paulsonnentag/button-grid/hardware/button-grid.kicad_pcb

## KiCad design hardware/button-grid.kicad_pcb (2026-10-14)

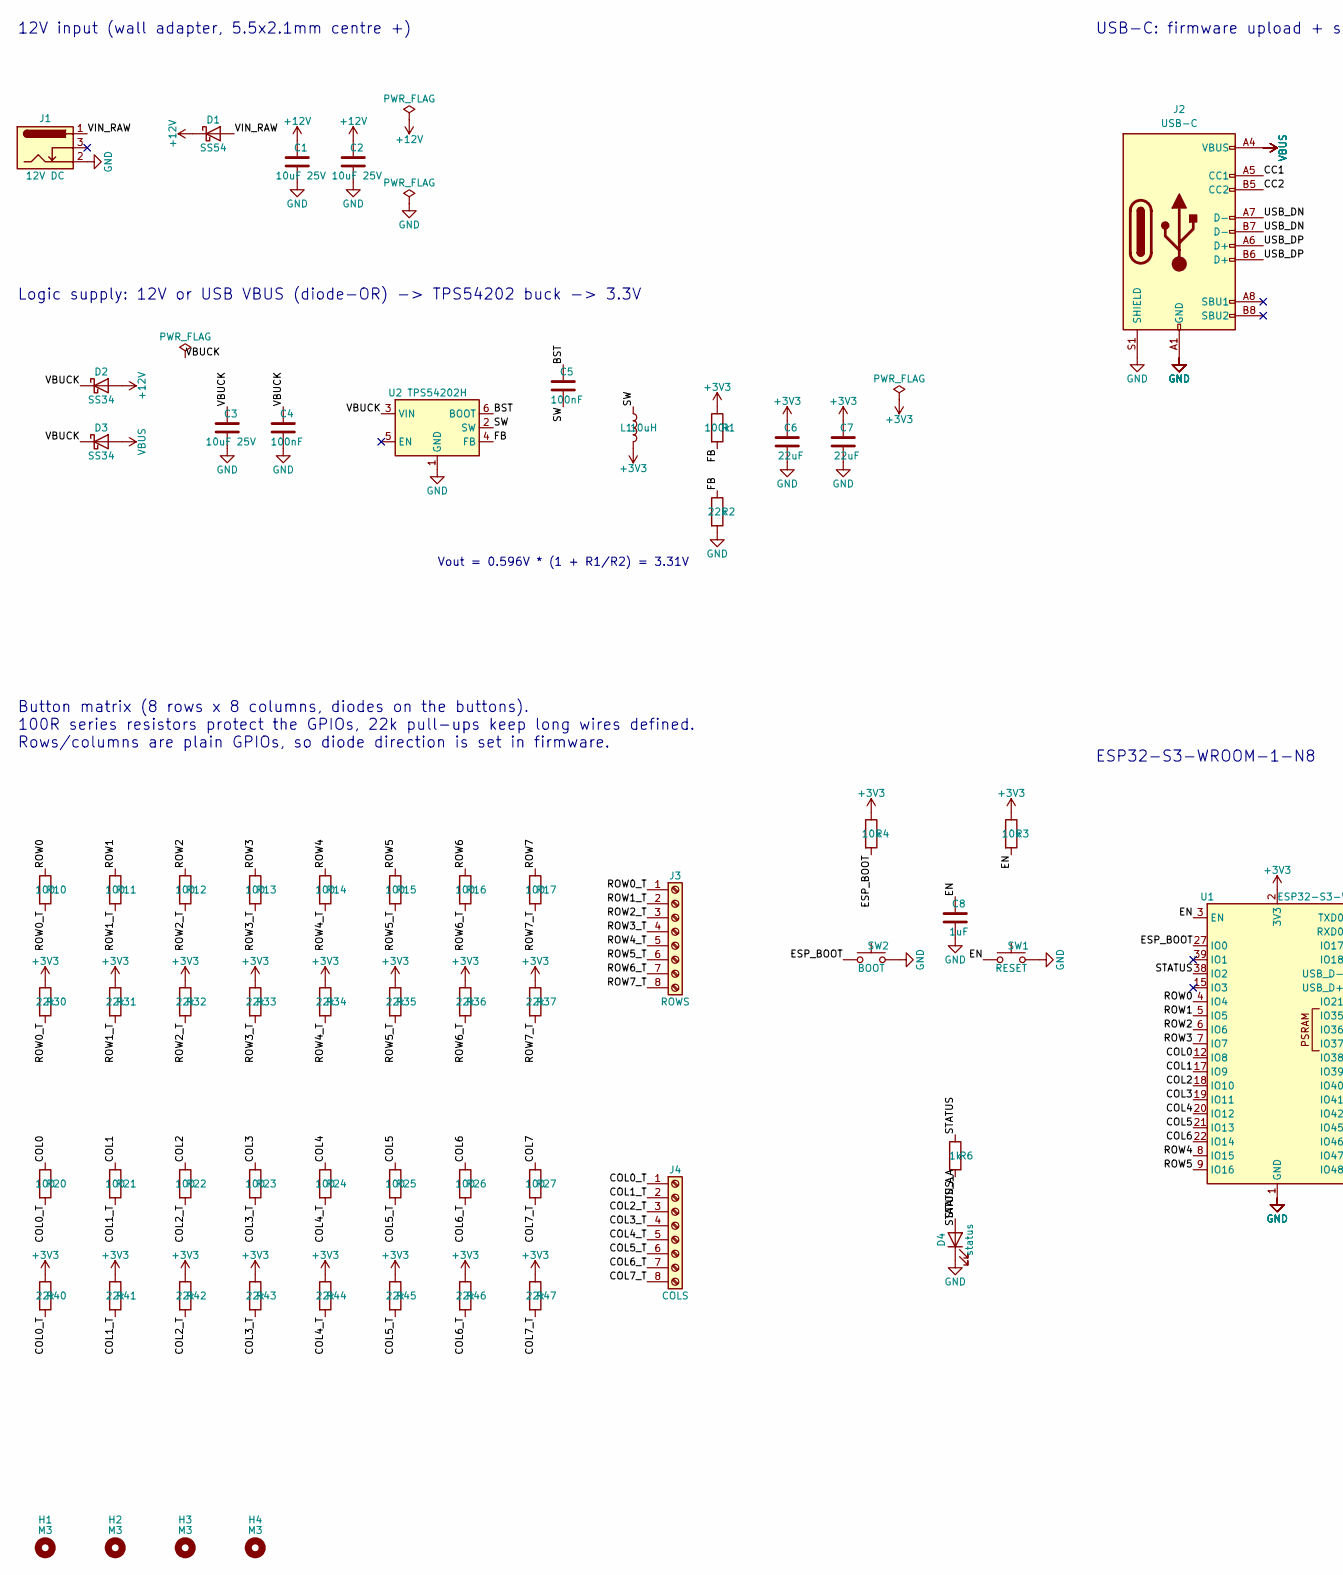
[picture p1: schematic button-grid.kicad_sch, 8x8 button grid controller, part in row 1, column 1]

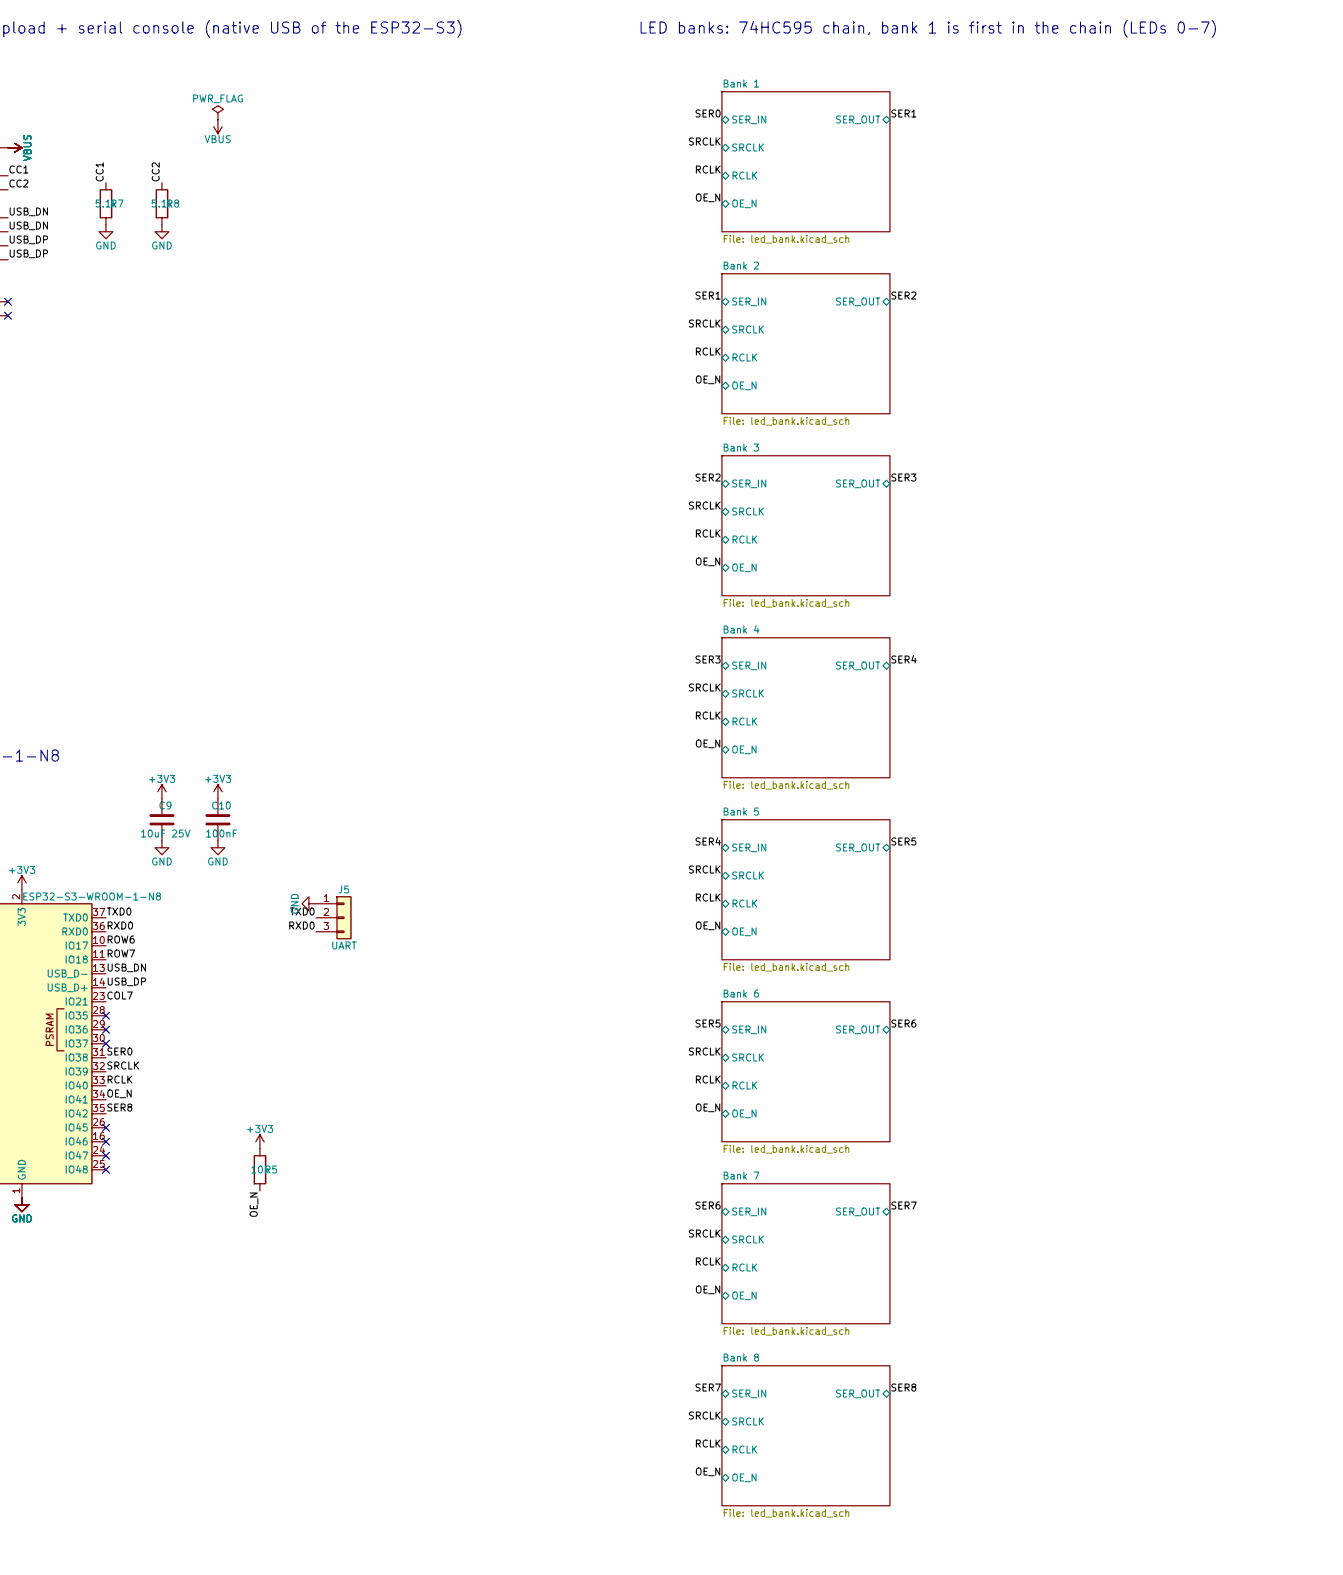
[picture p2: schematic button-grid.kicad_sch, 8x8 button grid controller, part in row 1, column 2]

Parts:
C1, C2, C3, C9: 10uF 25V; C_0805_2012Metric; LCSC C15850
C4, C5, C10: 100nF; C_0603_1608Metric; LCSC C14663
C6, C7: 22uF; C_0805_2012Metric; LCSC C45783
C8: 1uF; C_0603_1608Metric; LCSC C15849
D1: SS54; D_SMA; LCSC C22452
D2, D3: SS34; D_SMA; LCSC C8678
D4: status; LED_0603_1608Metric; LCSC C2286
H1, H2, H3, H4: M3; MountingHole_3.2mm_M3
J1: 12V DC; BarrelJack_Horizontal; LCSC C381116
J2: USB-C; USB_C_Receptacle_HRO_TYPE-C-31-M-12; LCSC C165948
J3: ROWS; TerminalBlock_Phoenix_PT-1,5-8-3.5-H_1x08_P3.50mm_Horizontal
J4: COLS; TerminalBlock_Phoenix_PT-1,5-8-3.5-H_1x08_P3.50mm_Horizontal
J5: UART; PinHeader_1x03_P2.54mm_Vertical
L1: 10uH; L_Sunlord_SWPA4030S; LCSC C38117
R1: 100k; R_0603_1608Metric; LCSC C25803
R2, R30, R31, R32, R33, R34, R35, R36, R37, R40, R41, R42, R43, R44, R45, R46, R47: 22k; R_0603_1608Metric; LCSC C31850
R3, R4, R5: 10k; R_0603_1608Metric; LCSC C25804
R6: 1k; R_0603_1608Metric; LCSC C21190
R7, R8: 5.1k; R_0603_1608Metric; LCSC C23186
R10, R11, R12, R13, R14, R15, R16, R17, R20, R21, R22, R23, R24, R25, R26, R27: 100; R_0603_1608Metric; LCSC C22775
SW1: RESET; SW_PUSH_6mm
SW2: BOOT; SW_PUSH_6mm
U1: ESP32-S3-WROOM-1-N8; ESP32-S3-WROOM-1; LCSC C2913198
U2: TPS54202H; TSOT-23-6; LCSC C527684

Connections:
/BST: C5.1, U2.6 (BOOT)
/CC1: J2.A5 (CC1), R7.1
/CC2: J2.B5 (CC2), R8.1
/COL0: R20.1, U1.12 (IO8)
/COL0_T: J4.1, R20.2, R40.2
/COL1: R21.1, U1.17 (IO9)
/COL1_T: J4.2, R21.2, R41.2
/COL2: R22.1, U1.18 (IO10)
/COL2_T: J4.3, R22.2, R42.2
/COL3: R23.1, U1.19 (IO11)
/COL3_T: J4.4, R23.2, R43.2
/COL4: R24.1, U1.20 (IO12)
/COL4_T: J4.5, R24.2, R44.2
/COL5: R25.1, U1.21 (IO13)
/COL5_T: J4.6, R25.2, R45.2
/COL6: R26.1, U1.22 (IO14)
/COL6_T: J4.7, R26.2, R46.2
/COL7: R27.1, U1.23 (IO21)
/COL7_T: J4.8, R27.2, R47.2
/EN: C8.1, R3.2, SW1.1, U1.3 (EN)
/ESP_BOOT: R4.2, SW2.1, U1.27 (IO0)
/FB: R1.2, R2.1, U2.4 (FB)
/OE_N: R5.2, U1.34 (IO41); also elsewhere on the board
/RCLK: U1.33 (IO40); also elsewhere on the board
/ROW0: R10.1, U1.4 (IO4)
/ROW0_T: J3.1, R10.2, R30.2
/ROW1: R11.1, U1.5 (IO5)
/ROW1_T: J3.2, R11.2, R31.2
/ROW2: R12.1, U1.6 (IO6)
/ROW2_T: J3.3, R12.2, R32.2
/ROW3: R13.1, U1.7 (IO7)
/ROW3_T: J3.4, R13.2, R33.2
/ROW4: R14.1, U1.8 (IO15)
/ROW4_T: J3.5, R14.2, R34.2
/ROW5: R15.1, U1.9 (IO16)
/ROW5_T: J3.6, R15.2, R35.2
/ROW6: R16.1, U1.10 (IO17)
/ROW6_T: J3.7, R16.2, R36.2
/ROW7: R17.1, U1.11 (IO18)
/ROW7_T: J3.8, R17.2, R37.2
/RXD0: J5.3, U1.36 (RXD0)
/SER0: U1.31 (IO38); also elsewhere on the board
/SER8: U1.35 (IO42); also elsewhere on the board
/SRCLK: U1.32 (IO39); also elsewhere on the board
/STATUS: R6.1, U1.38 (IO2)
/STATUS_A: D4.2 (A), R6.2
/SW: C5.2, L1.1, U2.2 (SW)
/TXD0: J5.2, U1.37 (TXD0)
/USB_DN: J2.A7 (D-), J2.B7 (D-), U1.13 (USB_D-)
/USB_DP: J2.A6 (D+), J2.B6 (D+), U1.14 (USB_D+)
/VIN_RAW: D1.2 (A), J1.1

Notes on the sheet:
12V input (wall adapter, 5.5x2.1mm centre +)
Logic supply: 12V or USB VBUS (diode-OR) -> TPS54202 buck -> 3.3V
Vout = 0.596V * (1 + R1/R2) = 3.31V
USB-C: firmware upload + serial console (native USB of the ESP32-S3)
ESP32-S3-WROOM-1-N8
Button matrix (8 rows x 8 columns, diodes on the buttons). 100R series resistors protect the GPIOs, 22k pull-ups keep long wires defined. Rows/columns are plain GPIOs, so diode direction is set in firmware.
LED banks: 74HC595 chain, bank 1 is first in the chain (LEDs 0-7)

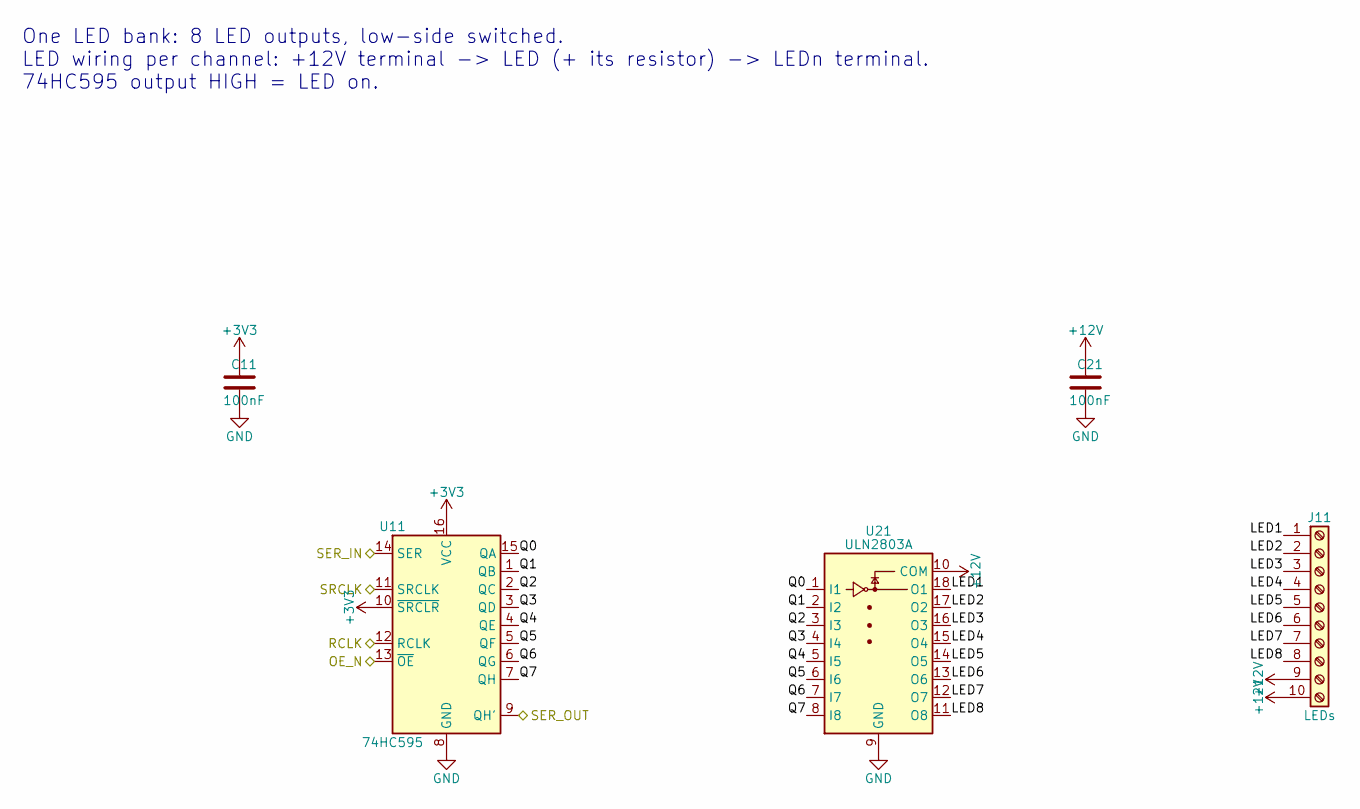
[picture p3: schematic led_bank.kicad_sch, LED bank (8 channels)]

Parts:
C11, C21: 100nF; C_0603_1608Metric; LCSC C14663
J11: LEDs; TerminalBlock_Phoenix_PT-1,5-10-3.5-H_1x10_P3.50mm_Horizont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
U11: 74HC595; SOIC-16_3.9x9.9mm_P1.27mm; LCSC C5947
U21: ULN2803A; SOIC-18W_7.5x11.6mm_P1.27mm; LCSC C9683

Connections:
/Bank 1/LED1: J11.1, U21.18 (O1)
/Bank 1/LED2: J11.2, U21.17 (O2)
/Bank 1/LED3: J11.3, U21.16 (O3)
/Bank 1/LED4: J11.4, U21.15 (O4)
/Bank 1/LED5: J11.5, U21.14 (O5)
/Bank 1/LED6: J11.6, U21.13 (O6)
/Bank 1/LED7: J11.7, U21.12 (O7)
/Bank 1/LED8: J11.8, U21.11 (O8)
/Bank 1/Q0: U11.15 (QA), U21.1 (I1)
/Bank 1/Q1: U11.1 (QB), U21.2 (I2)
/Bank 1/Q2: U11.2 (QC), U21.3 (I3)
/Bank 1/Q3: U11.3 (QD), U21.4 (I4)
/Bank 1/Q4: U11.4 (QE), U21.5 (I5)
/Bank 1/Q5: U11.5 (QF), U21.6 (I6)
/Bank 1/Q6: U11.6 (QG), U21.7 (I7)
/Bank 1/Q7: U11.7 (QH), U21.8 (I8)
/OE_N: U11.13 (~OE); also elsewhere on the board
/RCLK: U11.12 (RCLK); also elsewhere on the board
/SER0: U11.14 (SER); also elsewhere on the board
/SER1: U11.9 (QH'); also elsewhere on the board
/SRCLK: U11.11 (SRCLK); also elsewhere on the board

Parts of its further copies:
C12, C13, C14, C15, C16, C17, C18, C22, C23, C24, C25, C26, C27, C28: 100nF; C_0603_1608Metric; LCSC C14663
J12, J13, J14, J15, J16, J17, J18: LEDs; TerminalBlock_Phoenix_PT-1,5-10-3.5-H_1x10_P3.50mm_Horizont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
U12, U13, U14, U15, U16, U17, U18: 74HC595; SOIC-16_3.9x9.9mm_P1.27mm; LCSC C5947
U22, U23, U24, U25, U26, U27, U28: ULN2803A; SOIC-18W_7.5x11.6mm_P1.27mm; LCSC C9683

Connections of its further copies:
/Bank 2/LED1: J12.1, U22.18 (O1)
/Bank 2/LED2: J12.2, U22.17 (O2)
/Bank 2/LED3: J12.3, U22.16 (O3)
/Bank 2/LED4: J12.4, U22.15 (O4)
/Bank 2/LED5: J12.5, U22.14 (O5)
/Bank 2/LED6: J12.6, U22.13 (O6)
/Bank 2/LED7: J12.7, U22.12 (O7)
/Bank 2/LED8: J12.8, U22.11 (O8)
/Bank 2/Q0: U12.15 (QA), U22.1 (I1)
/Bank 2/Q1: U12.1 (QB), U22.2 (I2)
/Bank 2/Q2: U12.2 (QC), U22.3 (I3)
/Bank 2/Q3: U12.3 (QD), U22.4 (I4)
/Bank 2/Q4: U12.4 (QE), U22.5 (I5)
/Bank 2/Q5: U12.5 (QF), U22.6 (I6)
/Bank 2/Q6: U12.6 (QG), U22.7 (I7)
/Bank 2/Q7: U12.7 (QH), U22.8 (I8)
/Bank 3/LED1: J13.1, U23.18 (O1)
/Bank 3/LED2: J13.2, U23.17 (O2)
/Bank 3/LED3: J13.3, U23.16 (O3)
/Bank 3/LED4: J13.4, U23.15 (O4)
/Bank 3/LED5: J13.5, U23.14 (O5)
/Bank 3/LED6: J13.6, U23.13 (O6)
/Bank 3/LED7: J13.7, U23.12 (O7)
/Bank 3/LED8: J13.8, U23.11 (O8)
/Bank 3/Q0: U13.15 (QA), U23.1 (I1)
/Bank 3/Q1: U13.1 (QB), U23.2 (I2)
/Bank 3/Q2: U13.2 (QC), U23.3 (I3)
/Bank 3/Q3: U13.3 (QD), U23.4 (I4)
/Bank 3/Q4: U13.4 (QE), U23.5 (I5)
/Bank 3/Q5: U13.5 (QF), U23.6 (I6)
/Bank 3/Q6: U13.6 (QG), U23.7 (I7)
/Bank 3/Q7: U13.7 (QH), U23.8 (I8)
/Bank 4/LED1: J14.1, U24.18 (O1)
/Bank 4/LED2: J14.2, U24.17 (O2)
/Bank 4/LED3: J14.3, U24.16 (O3)
/Bank 4/LED4: J14.4, U24.15 (O4)
/Bank 4/LED5: J14.5, U24.14 (O5)
/Bank 4/LED6: J14.6, U24.13 (O6)
/Bank 4/LED7: J14.7, U24.12 (O7)
/Bank 4/LED8: J14.8, U24.11 (O8)
/Bank 4/Q0: U14.15 (QA), U24.1 (I1)
/Bank 4/Q1: U14.1 (QB), U24.2 (I2)
/Bank 4/Q2: U14.2 (QC), U24.3 (I3)
/Bank 4/Q3: U14.3 (QD), U24.4 (I4)
/Bank 4/Q4: U14.4 (QE), U24.5 (I5)
/Bank 4/Q5: U14.5 (QF), U24.6 (I6)
/Bank 4/Q6: U14.6 (QG), U24.7 (I7)
/Bank 4/Q7: U14.7 (QH), U24.8 (I8)
/Bank 5/LED1: J15.1, U25.18 (O1)
/Bank 5/LED2: J15.2, U25.17 (O2)
/Bank 5/LED3: J15.3, U25.16 (O3)
/Bank 5/LED4: J15.4, U25.15 (O4)
/Bank 5/LED5: J15.5, U25.14 (O5)
/Bank 5/LED6: J15.6, U25.13 (O6)
/Bank 5/LED7: J15.7, U25.12 (O7)
/Bank 5/LED8: J15.8, U25.11 (O8)
/Bank 5/Q0: U15.15 (QA), U25.1 (I1)
/Bank 5/Q1: U15.1 (QB), U25.2 (I2)
/Bank 5/Q2: U15.2 (QC), U25.3 (I3)
/Bank 5/Q3: U15.3 (QD), U25.4 (I4)
/Bank 5/Q4: U15.4 (QE), U25.5 (I5)
/Bank 5/Q5: U15.5 (QF), U25.6 (I6)
/Bank 5/Q6: U15.6 (QG), U25.7 (I7)
/Bank 5/Q7: U15.7 (QH), U25.8 (I8)
/Bank 6/LED1: J16.1, U26.18 (O1)
/Bank 6/LED2: J16.2, U26.17 (O2)
/Bank 6/LED3: J16.3, U26.16 (O3)
/Bank 6/LED4: J16.4, U26.15 (O4)
/Bank 6/LED5: J16.5, U26.14 (O5)
/Bank 6/LED6: J16.6, U26.13 (O6)
/Bank 6/LED7: J16.7, U26.12 (O7)
/Bank 6/LED8: J16.8, U26.11 (O8)
/Bank 6/Q0: U16.15 (QA), U26.1 (I1)
/Bank 6/Q1: U16.1 (QB), U26.2 (I2)
/Bank 6/Q2: U16.2 (QC), U26.3 (I3)
/Bank 6/Q3: U16.3 (QD), U26.4 (I4)
/Bank 6/Q4: U16.4 (QE), U26.5 (I5)
/Bank 6/Q5: U16.5 (QF), U26.6 (I6)
/Bank 6/Q6: U16.6 (QG), U26.7 (I7)
/Bank 6/Q7: U16.7 (QH), U26.8 (I8)
/Bank 7/LED1: J17.1, U27.18 (O1)
/Bank 7/LED2: J17.2, U27.17 (O2)
/Bank 7/LED3: J17.3, U27.16 (O3)
/Bank 7/LED4: J17.4, U27.15 (O4)
/Bank 7/LED5: J17.5, U27.14 (O5)
/Bank 7/LED6: J17.6, U27.13 (O6)
/Bank 7/LED7: J17.7, U27.12 (O7)
/Bank 7/LED8: J17.8, U27.11 (O8)
/Bank 7/Q0: U17.15 (QA), U27.1 (I1)
/Bank 7/Q1: U17.1 (QB), U27.2 (I2)
/Bank 7/Q2: U17.2 (QC), U27.3 (I3)
/Bank 7/Q3: U17.3 (QD), U27.4 (I4)
/Bank 7/Q4: U17.4 (QE), U27.5 (I5)
/Bank 7/Q5: U17.5 (QF), U27.6 (I6)
/Bank 7/Q6: U17.6 (QG), U27.7 (I7)
/Bank 7/Q7: U17.7 (QH), U27.8 (I8)
/Bank 8/LED1: J18.1, U28.18 (O1)
/Bank 8/LED2: J18.2, U28.17 (O2)
/Bank 8/LED3: J18.3, U28.16 (O3)
/Bank 8/LED4: J18.4, U28.15 (O4)
/Bank 8/LED5: J18.5, U28.14 (O5)
/Bank 8/LED6: J18.6, U28.13 (O6)
/Bank 8/LED7: J18.7, U28.12 (O7)
/Bank 8/LED8: J18.8, U28.11 (O8)
/Bank 8/Q0: U18.15 (QA), U28.1 (I1)
/Bank 8/Q1: U18.1 (QB), U28.2 (I2)
/Bank 8/Q2: U18.2 (QC), U28.3 (I3)
/Bank 8/Q3: U18.3 (QD), U28.4 (I4)
/Bank 8/Q4: U18.4 (QE), U28.5 (I5)
/Bank 8/Q5: U18.5 (QF), U28.6 (I6)
/Bank 8/Q6: U18.6 (QG), U28.7 (I7)
/Bank 8/Q7: U18.7 (QH), U28.8 (I8)
/OE_N: U12.13 (~OE), U13.13 (~OE), U14.13 (~OE), U15.13 (~OE), U16.13 (~OE), U17.13 (~OE), U18.13 (~OE); also elsewhere on the board
/RCLK: U12.12 (RCLK), U13.12 (RCLK), U14.12 (RCLK), U15.12 (RCLK), U16.12 (RCLK), U17.12 (RCLK), U18.12 (RCLK); also elsewhere on the board
/SER1: U12.14 (SER); also elsewhere on the board
/SER2: U12.9 (QH'), U13.14 (SER)
/SER3: U13.9 (QH'), U14.14 (SER)
/SER4: U14.9 (QH'), U15.14 (SER)
/SER5: U15.9 (QH'), U16.14 (SER)
/SER6: U16.9 (QH'), U17.14 (SER)
/SER7: U17.9 (QH'), U18.14 (SER)
/SER8: U18.9 (QH'); also elsewhere on the board
/SRCLK: U12.11 (SRCLK), U13.11 (SRCLK), U14.11 (SRCLK), U15.11 (SRCLK), U16.11 (SRCLK), U17.11 (SRCLK), U18.11 (SRCLK); also elsewhere on the board

Notes on the sheet:
One LED bank: 8 LED outputs, low-side switched. LED wiring per channel: +12V terminal -> LED (+ its resistor) -> LEDn terminal. 74HC595 output HIGH = LED on.

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
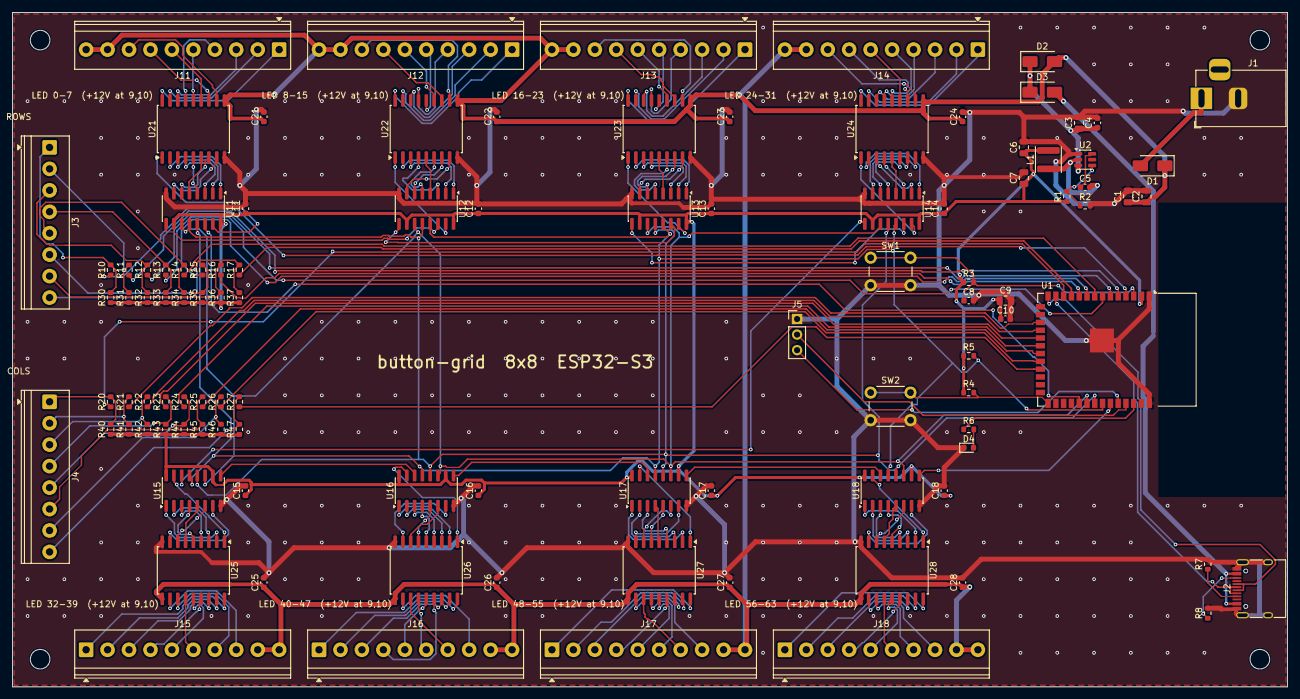
[picture p4: board button-grid.kicad_pcb from above]

Board: 2 copper layers, 208.0 x 110.0 mm, 108 parts (0 on the bottom side), 191 nets.
