paulsonnentag/button-grid/(commit log)

2026-10-14 Add generated KiCad project, checks, JLCPCB export and Pages site (WIP: routing)
    Claude-Session: https://claude.ai/code/session_01USgdVYHDQPVjqMcbCmVwPa
    [button-grid.kicad_pcb, button-grid.kicad_sch, led_bank.kicad_sch]
2026-10-14 Pre-route USB-C VBUS bridge, add GND stitching vias
    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
2026-10-14 Regenerate project with deterministic UUIDs; route without optimizer; zoom renders
    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
    [button-grid.kicad_pcb, button-grid.kicad_sch, led_bank.kicad_sch]
2026-10-14 Fully routed board: 0 DRC errors, ERC/netlist checks pass
    - autorouted with Freerouting (10um clearance margin), locked USB VBUS bridge
    - GND pours both sides, stitching vias, solid GND on THT pins
    - run checks on every branch; Pages deploy from main
    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
    [button-grid.kicad_pcb, button-grid.kicad_sch]
